BoBo1529707515/lickometer/UARTNEW/Core/Src/main.c

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
/* Includes ------------------------------------------------------------------*/
#include "main.h"
#include "usart.h"
#include "gpio.h"

/* USER CODE BEGIN Includes */
#include "bsp_touchkey.h"
#include "stdio.h"
/* USER CODE END Includes */


void SystemClock_Config(void);
/**
  * @brief  The application entry point.
  * @retval int
  */
int main(void)
{
  /* USER CODE BEGIN 1 */
printf("TTP224 Touch Key Demo Start (HAL Library)\r\n");
  /* USER CODE END 1 */

  /* MCU Configuration--------------------------------------------------------*/

  /* Reset of all peripherals, Initializes the Flash interface and the Systick. */
  HAL_Init();

  /* Configure the system clock */
  SystemClock_Config();

  /* Initialize all configured peripherals */
  MX_GPIO_Init();
  MX_USART1_UART_Init();
  /* USER CODE BEGIN 2 */
  char*hello ="he\r\n";
  /* USER CODE END 2 */

  /* Infinite loop */
  /* USER CODE BEGIN WHILE */
  while (1)
  {
		
		
        if(Key_IN1_Scanf() == 1)
        {
            printf("Faucet Signal 1\r\n");
            HAL_Delay(300); // ????
        }
        
     
        if(Key_IN2_Scanf() == 1)
        {
            printf("Faucet Signal 2\r\n");
            HAL_Delay(300); 
        }
        
     
        if(Key_IN3_Scanf() == 1)
        {
            printf("Faucet Signal 3\r\n");
            HAL_Delay(300); 
        }
        
       
        if(Key_IN4_Scanf() == 1)
        {
            printf("Faucet Signal 4\r\n");
            HAL_Delay(300); 
        }
        
        HAL_Delay(50); 
    /* USER CODE END WHILE */

    /* USER CODE BEGIN 3 */
  }
  /* USER CODE END 3 */
}

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
