BoBo1529707515/lickometer/(commit log)

2025-09-26 Create Configuration code for STM32F103C8T6
2025-09-26 Rename Configuration code for STM32F103C8T6 to Configuration code for STM32F103C8T6.md
2025-09-28 提交文件
    [SerialData_20250923_120735_part1.csv, SerialData_20250923_123607_part1.csv, SerialData_20250925_175842_part1.csv, SerialData_20250926_175030_part1.csv, SerialData_20250926_180017_part2.csv, SerialData_20250926_181021_part3.csv, serial_data_20250923_115153_part1.csv, serial_data_20250923_115232_part1.csv]
