BoBo1529707515/lickometer/(notices)

Notices in the files:
UARTNEW/Core/Src/main.c:
Copyright (c) 2025 STMicroelectronics.
All rights reserved.
This software is licensed under terms that can be found in the LICENSE file
